Juniorlef11/samsters-land-hestia/docs/Stage3_Tuning_Checklist.md

# 🔧 Samster's Land HESTIA — Λίστα Tuning (Στάδιο 3)

> Ρύθμιση ελέγχου τρίοδης με πραγματικά δεδομένα. Καλοκαίρι = δοκιμή σε **ΨΥΞΗ**
> (ο χρόνος σταθεροποίησης ισχύει και για χειμώνα — ίδιοι σωλήνες/ροή/40m).

---

## ✅ Pre-flight (πριν ξεκινήσεις)

**Flags στο `src/levitostatio/main.cpp`:**
- [ ] `SIM_MODE = false`  (πραγματικοί αισθητήρες)
- [ ] `DRY_RUN = false`   (οδηγεί relays στ' αλήθεια)
- [ ] `CALIBRATE_VALVE = false`
- [ ] `RELAY_SELFTEST = false`
- [ ] `VALVE_TRAVEL_MS = 77000` ✓ (ήδη μετρημένο)

**Υλικό / υδραυλικά:**
- [ ] Αισθητήρες δίνουν λογικές τιμές (όχι `--`): προσαγωγή, κρύο buffer, εξωτερική, δωμάτιο
- [ ] ROM mapping σωστό (κάθε αισθητήρας = σωστός ρόλος — δες `printSensorAddresses`)
- [ ] Αντλία θερμότητας σε ΨΥΞΗ (κρύο buffer έτοιμο)
- [ ] **Ένα κύκλωμα ανοιχτό για ροή** (fancoil = ασφαλές· ενδοδαπέδια = πρόσεχε συμπύκνωση)
- [ ] Εποχή = καλοκαίρι, `/floorcool` όπως θες (off = μόνο fancoil = πιο ασφαλές)

---

## 👀 Τι να παρατηρείς (serial `[CTRL]` + OLED)

| # | Τι κοιτάς | ✅ Καλό σημάδι | ⚠️ Κακό σημάδι |
|---|---|---|---|
| 1 | **Τιμές αισθητήρων** | λογικοί αριθμοί | `--` / NaN / τρελές τιμές |
| 2 | **Φορά (ψύξη)** | «ΑΝΟΙΓΜΑ» → προσαγωγή **πέφτει** | προσαγωγή **ανεβαίνει** (= ανάποδα) |
| 3 | **Χρόνος σταθεροπ.** | σταματά να αλλάζει σε X s | (κατέγραψε το X!) |
| 4 | **Σύγκλιση** | πλησιάζει στόχο & μένει σε deadband | ταλάντωση (πάνω-κάτω από στόχο) |
| 5 | **Θέση βάνας** (`V__%`) | μένει 0–100, ταιριάζει με δείκτη | «κολλάει» στα άκρα συνέχεια |
| 6 | **Αντλία** | ON όταν ζήτηση+κρύο· όχι σπασμωδικά | ανοιγοκλείνει συνέχεια |
| 7 | **Ασφάλειες** | COOL_MIN κλείνει αν προσαγωγή<18 | δεν αντιδρά σε όριο |

---

## 🎛️ Τα «κουμπιά» — τι να γυρίσεις

**Το #1 που μετράμε: χρόνος σταθεροποίησης (settle)**
→ Μετά από έναν παλμό, πόσα δευτερόλεπτα κάνει η προσαγωγή να **σταματήσει να αλλάζει** (Δ < ~0.2°C);
→ Βάλε `SETTLE_MS` ≈ αυτόν τον χρόνο.

**Αν κάνει ΤΑΛΑΝΤΩΣΗ (overshoot/hunting):**
- `PULSE_PER_DEG` ↓ (π.χ. 1500 → 1000) — πιο ήπιοι παλμοί
- ή `PULSE_MAX` ↓ (π.χ. 8000 → 5000)
- ή `SETTLE_MS` ↑ — περίμενε περισσότερο

**Αν είναι ΠΟΛΥ ΑΡΓΟ (δεν φτάνει ποτέ):**
- `PULSE_PER_DEG` ↑
- ή `SETTLE_MS` ↓

**Αν «τρέμει» γύρω από τον στόχο:**
- `DEADBAND` ↑ λίγο (π.χ. 1.5 → 2.0)

---

## 📝 Τι να σημειώσεις για μένα
1. Χρόνος σταθεροποίησης (s) = ______
2. Κάνει overshoot; (ναι/όχι) = ______
3. Πόσο κρατά να φτάσει τον στόχο = ______
4. Φορά σωστή στην ψύξη; (προσαγωγή πέφτει στο «άνοιγμα») = ______

> Με αυτά τα 4 νούμερα ρυθμίζουμε τέλεια. **Χωρίς άγχος — αλλάζουμε, ξανα-flash, βλέπουμε.**

---

## 🛑 Ασφάλεια
- Πρώτη φορά: κράτα το χέρι κοντά στον διακόπτη 230V — αν δεις κάτι περίεργο, κόψε.
- Συμπύκνωση (ενδοδαπέδια ψύξη): η προστασία κρατά προσαγωγή ≥18°C — μην την παρακάμψεις.
- Αν η πλακέτα κάνει reboot → brownout USB → βάλε DIN τροφοδοτικό / powered hub.
