Juniorlef11/samsters-land-hestia/tools/history.csv

ts | hotTop | outdoor | cold | supply | powerW | room | rh | setpoint | dew | status | season | rssi | kwhDay
2026-06-12 14:00:17 |  |  |  |  | 0 |  |  | 24.5 |  | HEAT | summer | -81
2026-06-12 14:14:27 |  |  |  |  | 0 |  |  | 24.5 |  | HEAT | summer | -80
2026-06-12 14:15:00 |  |  |  |  | 0 |  |  | 24.5 |  | HEAT | summer | -80
2026-06-12 16:09:29 |  |  |  |  | 0 |  |  | 22.5 |  | HEAT | winter | -105
2026-06-13 02:06:52 |  |  |  |  | 0 |  |  | 22.5 |  | HEAT | winter | -25
2026-06-13 02:07:20 |  |  |  |  | 0 |  |  | 22.5 |  | HEAT | winter | -32
2026-06-13 12:35:52 |  |  |  |  | 0 |  |  | 22.5 |  | HEAT | summer | -63
2026-06-13 12:47:09 |  |  |  |  | 0 |  |  | 24.0 |  | HEAT | winter | -65
2026-06-13 13:17:41 |  |  |  |  | 0 |  |  | 20.5 |  | HEAT | winter | -61
2026-06-13 16:11:03 |  |  |  |  | 0 |  |  | 20.5 |  | HEAT | winter | -51
2026-06-13 16:17:45 |  |  |  |  | 0 | 25.9 |  | 22.5 |  | HEAT | winter | -63
2026-06-13 16:32:29 |  |  |  |  | 0 | 25.8 |  | 26.5 |  | HEAT | winter | -107
2026-06-13 16:33:37 |  |  |  |  | 0 | 25.8 |  | 26.5 |  | HEAT | winter | -102
2026-06-13 16:33:44 |  |  |  |  | 0 | 25.8 |  | 26.5 |  | HEAT | winter | -95
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
