Juniorlef11/samsters-land-hestia/(commit log)

2026-09-04 Initial commit — Samster's Land HESTIA
    Αυτόνομο σύστημα ελέγχου θέρμανσης/δροσισμού με LoRa για κοινή αντλία
    θερμότητας (ESP32/PlatformIO). 3 κόμβοι: levitostatio (S3), living_room
    (hub), cyd (οθόνη). PolyForm Noncommercial license.
    [history.csv, today.tsv]
2026-09-04 docs: English README (primary) + Greek README.el + architecture diagram
    - README.md -> English με Mermaid διάγραμμα αρχιτεκτονικής + language links
    - README.el.md -> ελληνική έκδοση
